Kaivalya461/wireless-start/app/src/main/ic_launcher-playstore.png

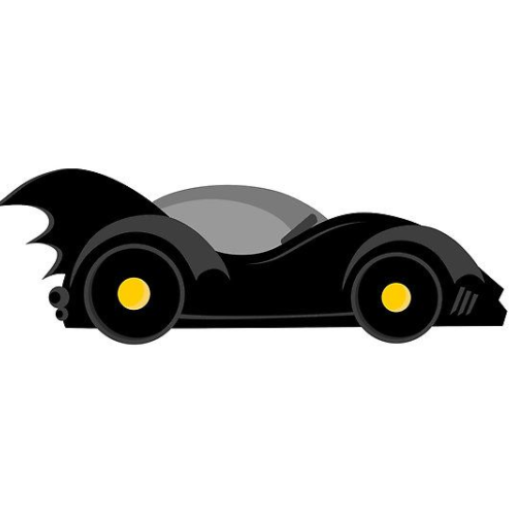
app/src/main/ic_launcher-playstore.png
