Kaivalya461/wireless-start/wear/src/main/ic_launcher-playstore.png

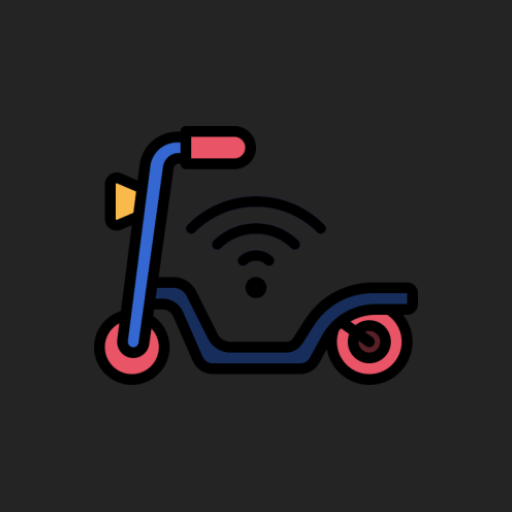
wear/src/main/ic_launcher-playstore.png
