Kaivalya461/wireless-start/nrf520/CarKeyless/BleManager.h

#ifndef BLE_MANAGER_H
#define BLE_MANAGER_H

#include <Arduino.h>

void initBle();
void transmitBatteryTelemetry(uint16_t mvPayload);
bool isBleClientConnected();
void updateBleAdvertisingState();
void setDeviceName(String newName);
void transmitConfigToApp();

#endif
