Kaivalya461/wireless-start/(commit log)

2026-07-21 Initiall Commit - Wireless Start app for Andriod and Wear
2026-07-22 Major Changes 1. Add Pulse Duration Options for both START and STOP buttons 2. Add ESP32 main_function logic 3. Update Wear OS events to work even if Phone App is completely off. 4. Add Reconnect But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
2026-07-23 QOL Improvements: 1. Fix Weap App getting in foreground(when in-memory); when ShortcutActivity was iniated 2. Add sending of TIME:1234567 event for syncing ESP32 timer 3.
    ESP32 Power Optimizations:
    1. Add Deep sleep during Night hours
    2. Optimize BLE Advert by setting the freq to few seconds
    [main_func.ino]
2026-07-23 Fix Deep Sleep Window time
    [main_func.ino]
2026-07-24 ESP32 main function fix on master for incorrect relay state on boot
    [main_func.ino]
2026-07-27 Remove STOP feature logic from ESP32 Code
2026-07-27 ESP32 V2 Code - Initial Commit 1. Refactor for modularity 2. Add tramission of Voltage Readings over BLE
2026-07-27 Add Live Battery Voltage readings Panel
2026-07-28 1. Remove STOP functionality from PhoneApp UI 2. Battery voltage toggle Color fix 3. Move Reconnect button in new 3-menu in connectivity panel
2026-07-28 Add Battery Voltage Historic Data Chart and Rearrange SystemActivityLog to the very top
2026-07-29 1. Code cleanup for PhoneApp MainActivity.java to improve code maintainibility 2. Remove STOP functionality from PreferenceManager.java 3. Fix incorrect Pulse Duration value printed in SystemActivity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
2026-07-30 1. ActiveHigh Refactor to support ESP32 MOSFET Replay 2. Battery Voltage Chart optimizations 3. Fixed Bluetooh Connection Status updates in SystemActivityLog 4. Connectivity Panel UI visual enhanceme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
    [Battery.cpp, Battery.h, BleManager.cpp, Relay.cpp]
2026-08-02 1. Add App icon 2. Add Active-Low toggle for relay pins 3. Fixed Voltage Reading 0.7V offset issue due the incorrect multipler
    [Battery.cpp, Relay.cpp, Relay.h]
2026-08-02 Add change to persist the SystemActivityLog logs and load current day logs onCreate
2026-08-04 v2.1 1. Reduce Battery Voltage Smoothing factor to make live readings reach actual value faster 2. Add Material Card for SystemActivityLog 3. Add New Log History Section for viewing past SystemLogs b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
2026-08-04 Voltage Chart - Change to 4h, 2d, 1m, all (previously 1h, 7d, 1y, all)
2026-08-05 Voltage Chart Optimizations - Remove addition of Float.NaN and update to split to sub-graphs when missing data
2026-08-07 1. Add onFailure for sendBleCommand to enable immediate failure haptics on watch 2. Fix Watch Command without PhoneApp in mem using default ESP32 MAC 3. Add BLE connect optimizations to improve Watch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
2026-08-07 Remove long durations voltage charts due to bad UX from gaps in the reading chart
2026-08-08 Disable 4H button to simplify and fix VoltageChart updating to incorrect chart and add back btn in activity_log_history
2026-08-08 Add Hardware Circuit Diagram and Component List Details
2026-08-09 1. Add Reconnect Button on the Connectivity Tile 2. Add Target Device Auto-Connect toggle for user controlled behaviour 3. Change Relay to Active-High due to addition of Driver Circuit for Relay Trig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
2026-08-12 1. Add change to delete 30days old VoltageReadings and SystemActivityLogs 2. Add change to initiate Reconnect Target Device when Auto-Connect flag is updated 3. Move updating DeviceName and MAC-AddAd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
2026-08-14 BLE Optimizations 1. PhoneApp - Custom BLE Scanner to avoid Android's lazy BT OS stack 2. ESP32 - Increase Tx Power to 9dB AND Change to NimBLE library 3. Half the CPU clock speed to 80Mhz to save cu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
    [BleManager.cpp, BleManager.h, ScooterKeyless.ino]
2026-08-15 Fix couple blemanager bugs introduced after addition of ProcessLifecycleOwner
2026-08-22 Wear App - Add ICON complication for Target Device connection status
2026-08-23 Add change to updateConnectionUI correctly in case of Reconnect workflow
2026-08-23 Add new Fail-Safe Stop Relay Workflow
    [BleManager.cpp, Relay.cpp, Relay.h, ScooterKeyless.ino]
2026-08-24 v2.3.0 1. Add New WirelessScooter AppIcon for both Phone and Wear App 2. Re-integrate STOP button functionality (only through Wear App) 3. Add About and Credits Popup in 3-dot Menu
2026-08-28 1. Add 24/7 Toggleable Background Service 2. Refactor Bluetooth Incoming message listener logic to new DeviceProtocolHandler class 3. Add new Scheduled Engine-Run layout in Wear with data & time pick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
2026-08-28 Add ESP32 Engine-Run Schedule Start/Kill Logic
2026-08-29 ESP32 Bugfix - Add change to expire the engine-run schedule after 2mins if not utilized
    [Relay.cpp]
2026-09-22 Add STOP button and fucntionality in Phone MainActivity
2026-09-29 Combine Conn and Control Layout 1. Add new App Header and move 3-dot menu from Conn Panel to this new panel 2. Compactify Vehicle Control Panel and move Live Batt toggle in App Settings 3. Combine Co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
2026-09-29 ESP32 Code Fix - Fix incorrect STOP relay duration issue
    [BleManager.cpp, ScooterKeyless.ino]
2026-10-20 1. New Device Pairing Layout to support multiple devices 2. Refactor MainActivity to display multiple vehicle control card 3. Refactored BleManager to support multiple Gatts 4. Improved BleForeground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
2026-10-23 v3.0.0-beta 1. New SSOT Repo for Ble Device Connections to fix missed connection updates with BleForegroundService 2. Add change to only allow max 2 Devices to be configured 3. Add change to show All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
2026-10-23 Add Last Stalled time in the BleForeground Notification
2026-10-24 Port ESP32 ScooterKeyless to nRF520 (excluding Battery Voltage Readings logic)
2026-10-25 More fixes: 1. Fix annoying onServicesReady triggers during app resume even though already connected 2. Add new Phone BT STATE_ON event logic to automatically start scan in case Phone BT is turned on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
2026-10-25 Hotfix broken Vehicle Card updates due to execution of events of background thread
2026-10-26 Add multi vehicle support for Voltage Readings
2026-10-26 Update esp32 eco-mode ble advert invert from 2-3 to 1-2 secs
2026-10-29 PreferenceManager Cleanup 1. Move all vehicle related functions to their respective repo, dao classes. 2. Add New is_default column in Vehicle to replace old prefs selectedVehicleId 3. Fix the Voltag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
2026-10-29 HotFix for the Multi Device connect fail
2026-11-06 1. Hotfix - Update CONFIG to CONF to reduce char length causing dataloss in transmitVehicleConfig due to exceeding deafult MTU limit 2. Update relay start/stop to D5 and D6 pins 3. Make both relays A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
2026-11-06 MainActivity Perf Optimizations: 1. Addition of DiffUtil for VehicleCard updates 2. Delayed pruneOldDatabaseRecords from 5sec to 20sec post app launch 3. Offload pruneOldDatabaseRecords execution fro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
2026-11-06 Add readme in nRF52 module containing electronic hardware list and circuit diagram
2026-11-07 1. Updade Manage-Vehicle screen to filter results with Serial UUID filtered 2. Add Rescan button in Scan Nearby Devices popup 3. Fix global-scan staying live even when BT was turned off
2026-11-11 Add CarKeyless NRF52 project 1. Contains Lock/Unlock utilizing ScooterKeyless as baseline 2. Live Battery voltage reading and transmit over BLE for tracking nrf52 battery 3. Supports Lock/Unlock usin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
2026-11-11 Support for CarKeyless 1. Add new Power toggle which uses PWR:ON and PWR:OFF commands 2. New VehicleControlType to identify between START/STOP and LOCK/UNLOCK 3. Fixed App Settings layout format inco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
2026-11-13 CarKeyless nrf52 (v4.0) - 1. Fixed Live battery readings which was off by -.10V 2. Update BleManager with Command Ack events
2026-11-13 v4.0 1. New BleCommandManager to centralize all ble command related logic 2. Make WearMessageListenerService work Independantly from MainActivity using new BleCommandManager 3. New READY_FOR_CONTROL 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
